DevVitek2/RODIA-Pathfinder/images/sch_bmp.png

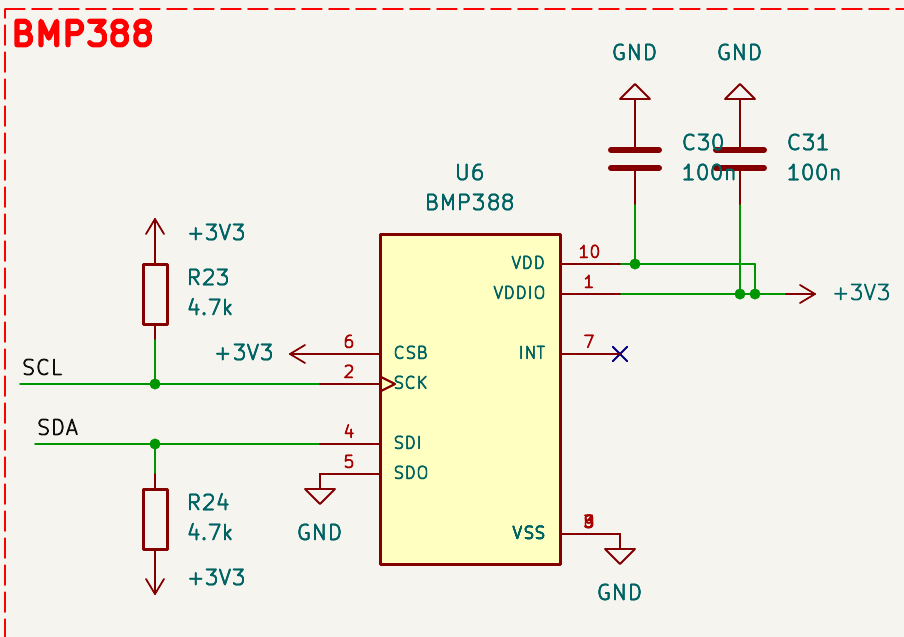
images/sch_bmp.png
