DevVitek2/RODIA-Pathfinder/images/sch_crystal.png

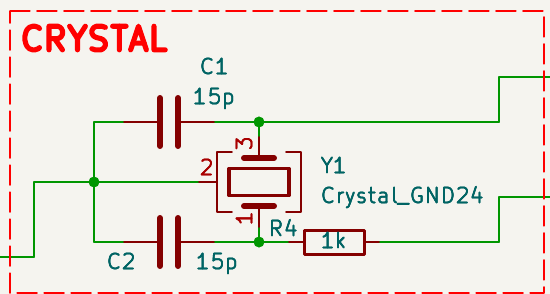
images/sch_crystal.png
