DevVitek2/RODIA-Pathfinder/images/sch_full.png

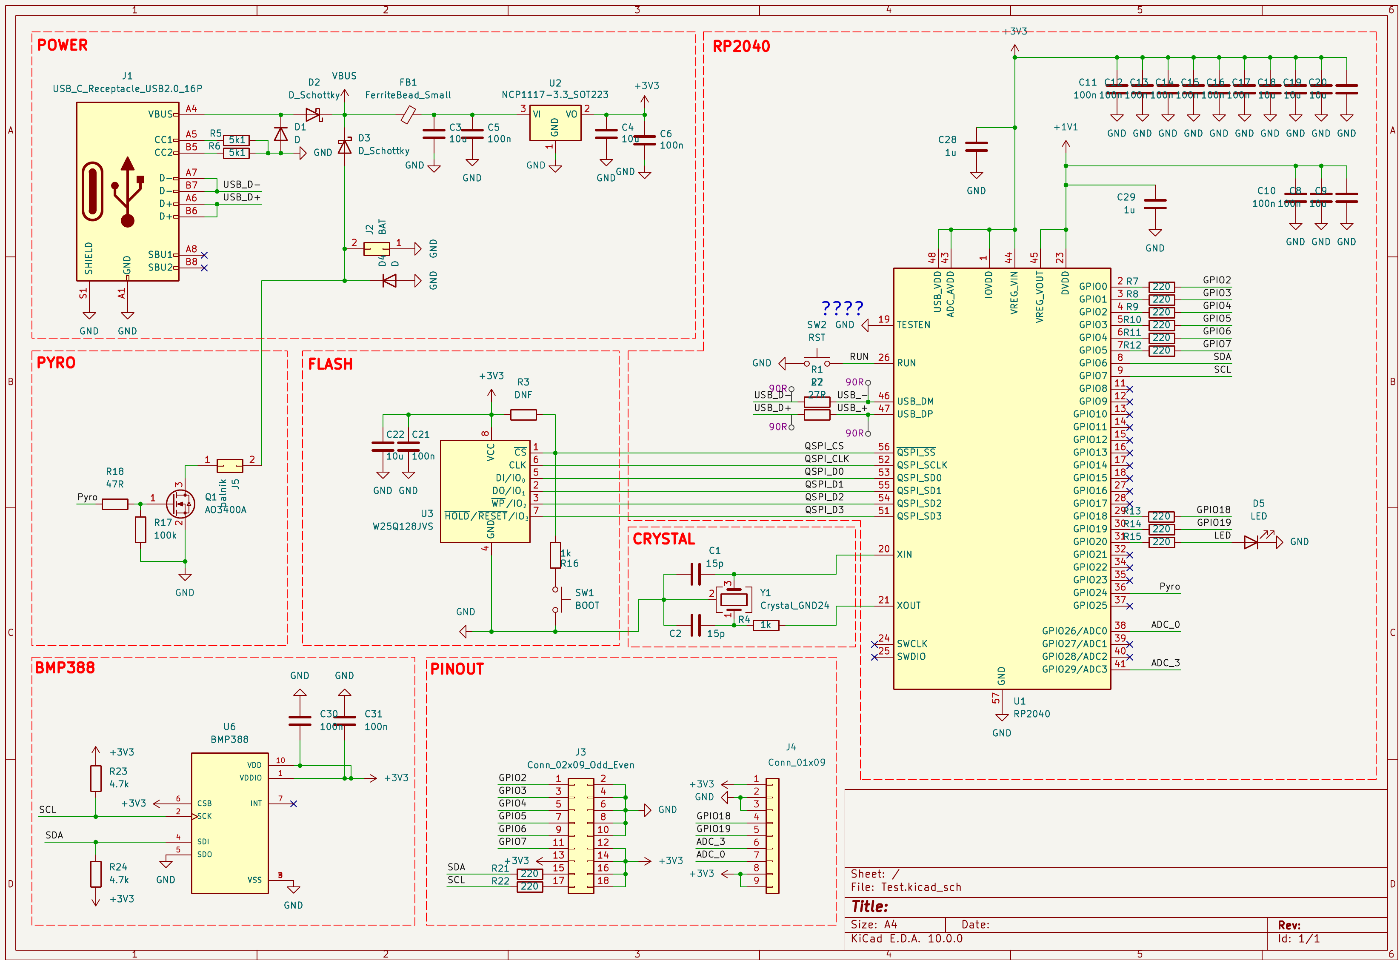
images/sch_full.png
