DevVitek2/RODIA-Pathfinder/images/sch_mcu.png

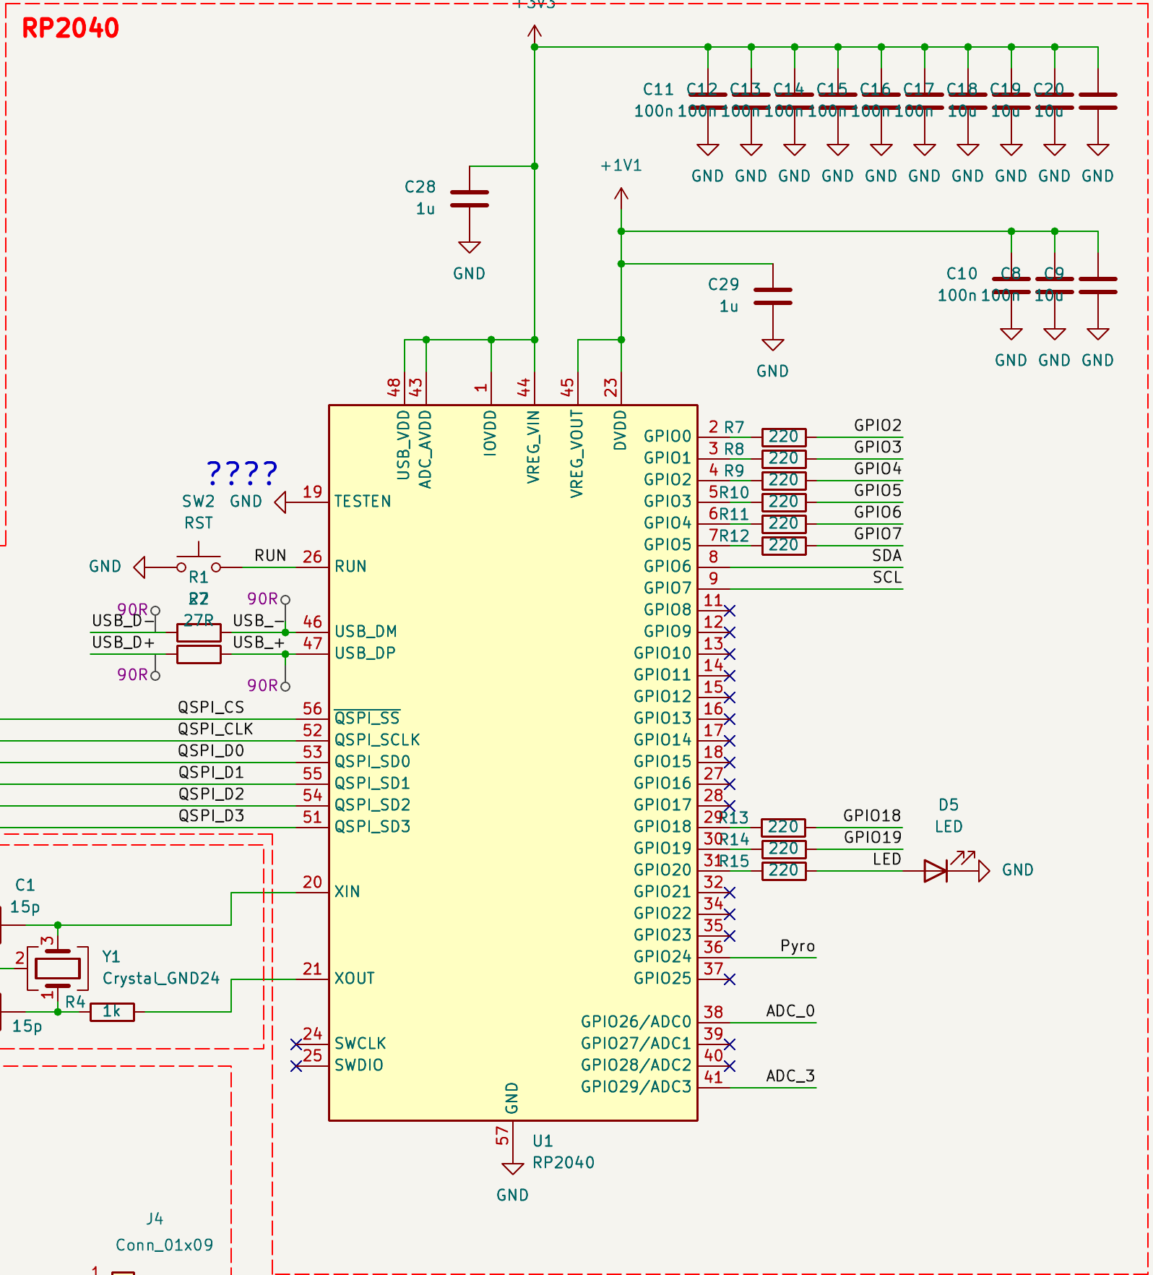
images/sch_mcu.png
