DevVitek2/RODIA-Pathfinder/images/sch_pinout.png

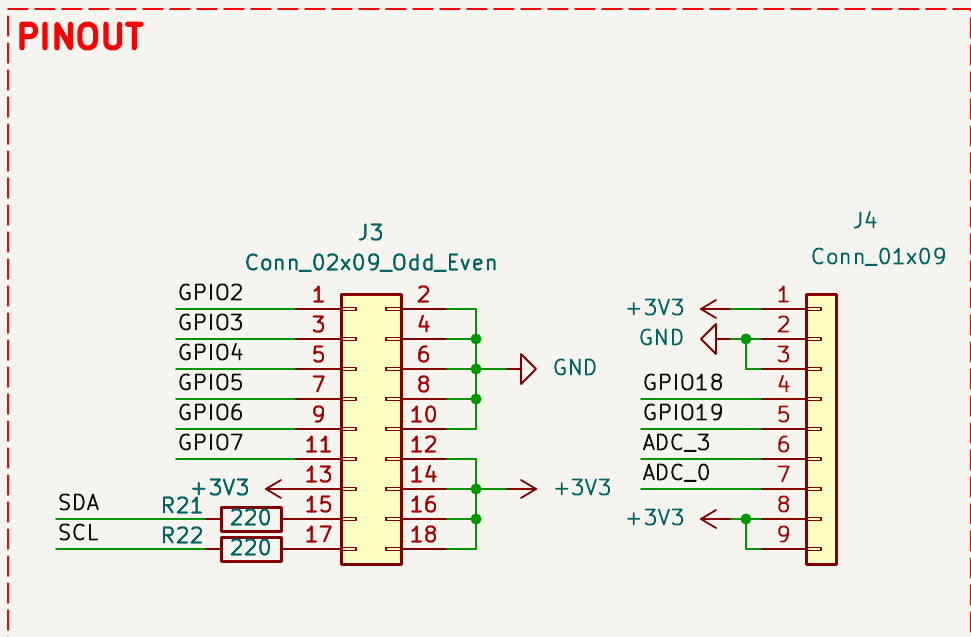
images/sch_pinout.png
