DevVitek2/RODIA-Pathfinder/images/sch_power.png

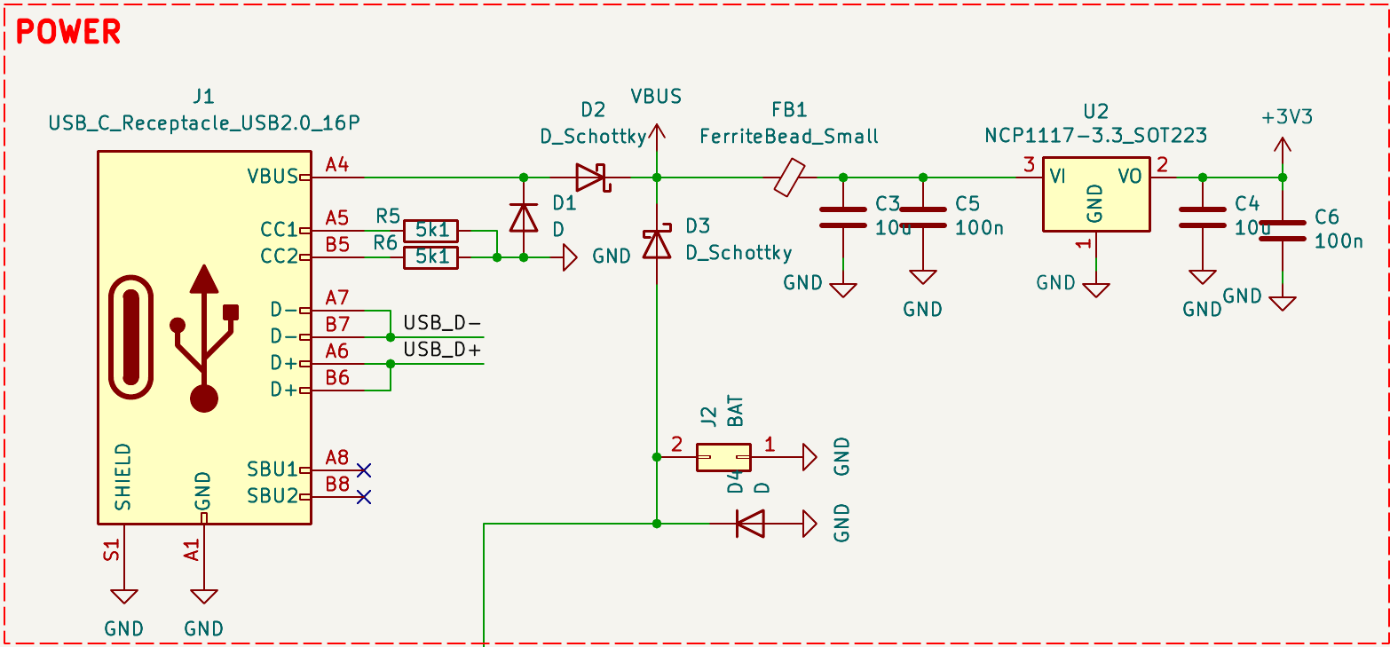
images/sch_power.png
