DevVitek2/RODIA-Pathfinder/rodia-pathfinder/PCB2.3_JF/imgs_production/2026-07-18_00-21.png

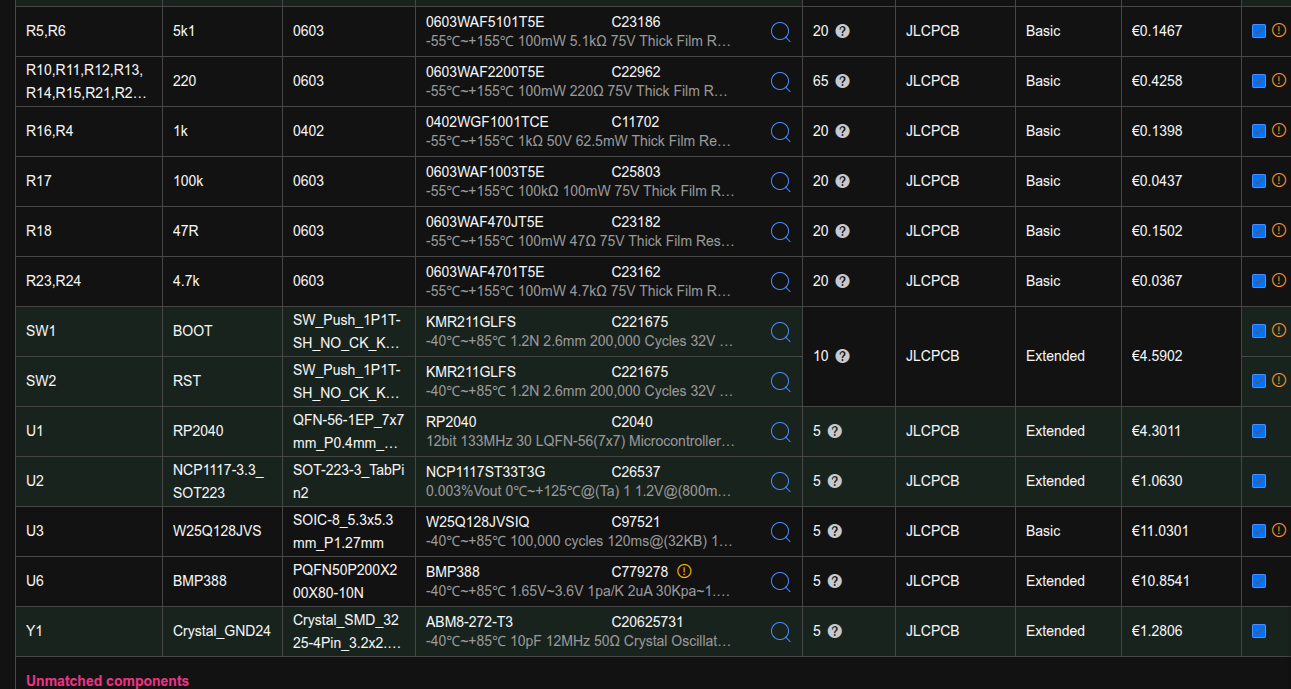
rodia-pathfinder/PCB2.3_JF/imgs_production/2026-07-18_00-21.png
