DevVitek2/RODIA-Pathfinder/rodia-pathfinder/PCB2.3_JF/production/bom.csv

Designator | Footprint | Quantity | Value | LCSC Part #
C1, C2 | 0402 | 2 | 15p
C10, C11, C12, C13, C14, C15, C16, C17, C21, C30, C31, C5, C6, C8 | 0402 | 14 | 100n
C18, C19, C20, C22, C3, C4, C9 | 0402 | 7 | 10u
C28, C29 | 0402 | 2 | 1u
D1, D4 | D_SMB | 2 | D
D2, D3 | D_SMA | 2 | D_Schottky
D5 | 0805 | 1 | LED
FB1 | 0805 | 1 | FerriteBead_Small
J1 | USB_C_Receptacle_HCTL_HC-TYPE-C-16P-01A | 1 | USB_C_Receptacle_USB2.0_16P
J2 | AMASS_XT30UPB-M_1x02_P5.0mm_Vertical | 1 | BAT
J3 | PinSocket_2x09_P2.54mm_Vertical | 1 | Conn_02x09_Odd_Even
J4 | PinSocket_1x09_P2.54mm_Vertical | 1 | Conn_01x09
J5 | AMASS_XT30UPB-M_1x02_P5.0mm_Vertical | 1 | palnik
Q1 | SOT-23 | 1 | AO3400A
R1 | 0402 | 1 | 27
R10, R11, R12, R13, R14, R15, R21, R22, R7, R8, R9 | 0603 | 11 | 220
R16, R4 | 0402 | 2 | 1k
R17 | 0603 | 1 | 100k
R18 | 0603 | 1 | 47R
R2 | 0402 | 1 | 27R
R23, R24 | 0603 | 2 | 4.7k
R3 | 0603 | 1 | DNF
R5, R6 | 0603 | 2 | 5k1
SW1 | SW_Push_1P1T-SH_NO_CK_KMR2xxG | 1 | BOOT
SW2 | SW_Push_1P1T-SH_NO_CK_KMR2xxG | 1 | RST
U1 | QFN-56-1EP_7x7mm_P0.4mm_EP3.2x3.2mm_ThermalVias | 1 | RP2040
U2 | SOT-223-3_TabPin2 | 1 | NCP1117-3.3_SOT223
U3 | SOIC-8_5.3x5.3mm_P1.27mm | 1 | W25Q128JVS
U6 | PQFN50P200X200X80-10N | 1 | BMP388
Y1 | Crystal_SMD_3225-4Pin_3.2x2.5mm | 1 | Crystal_GND24
