DevVitek2/RODIA-Pathfinder/images/schematic.pdf

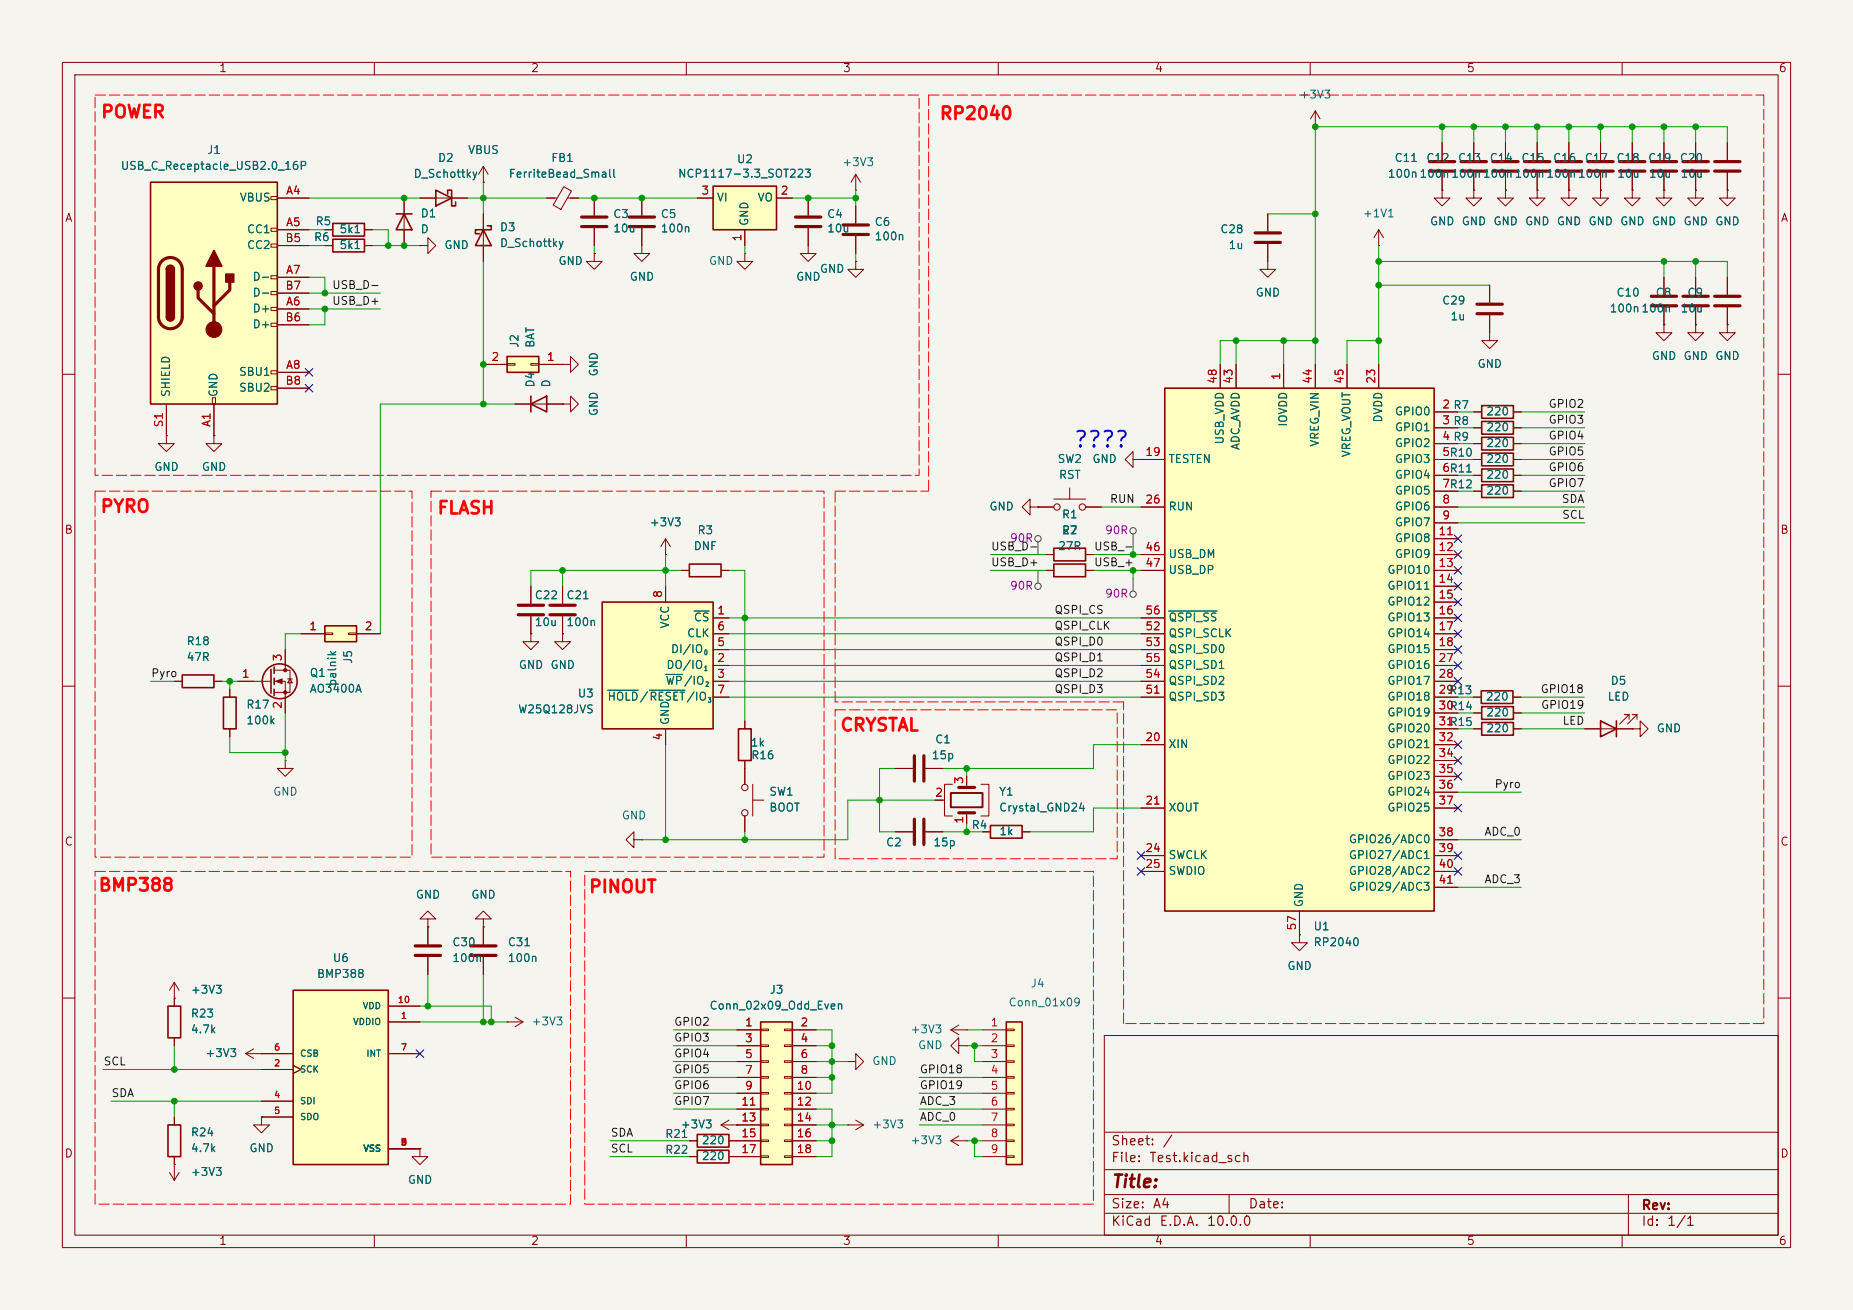
[picture p28: page 1]

2 3J5 palnik 1 2 U3 W25Q128JVS CS 1 DO/IO1 2 WP/IO2 3 GND

4 DI/IO0 5 CLK 6 HOLD/RESET/IO3 7 VCC

Size: A4 | Rev:
KiCad E.D.A. 10.0.0 | Id: 1/1
