DevVitek2/RODIA-Pathfinder/rodia/RODIA_block_diagram.pdf

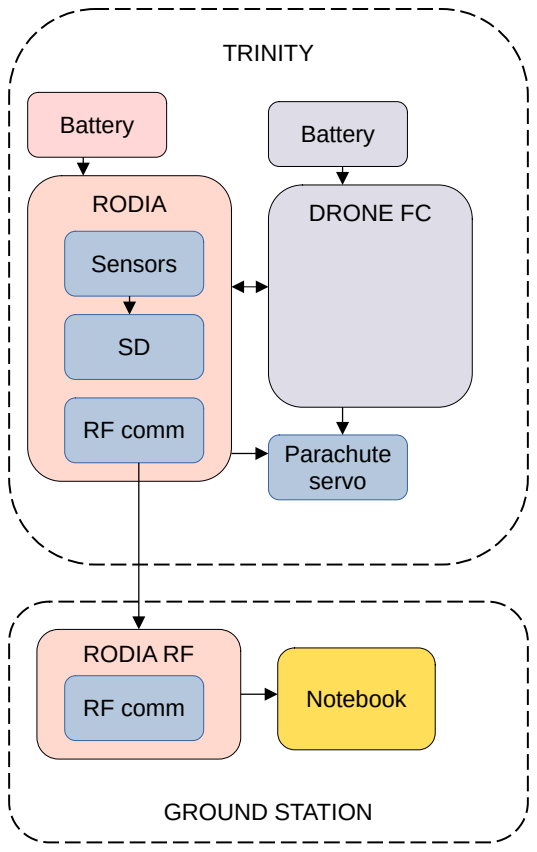
[picture p29: page 1]
RODIA; Sensors; RF comm; Battery; DRONE FC; RODIA RF; TRINITY; Parachute servo; GROUND STATION; Notebook
