DevVitek2/RODIA-Pathfinder/rodia-pathfinder/PCB2.3_JF/Test.kicad_pcb

## KiCad design rodia-pathfinder/PCB2.3_JF/Test.kicad_pcb (2026-10-26)

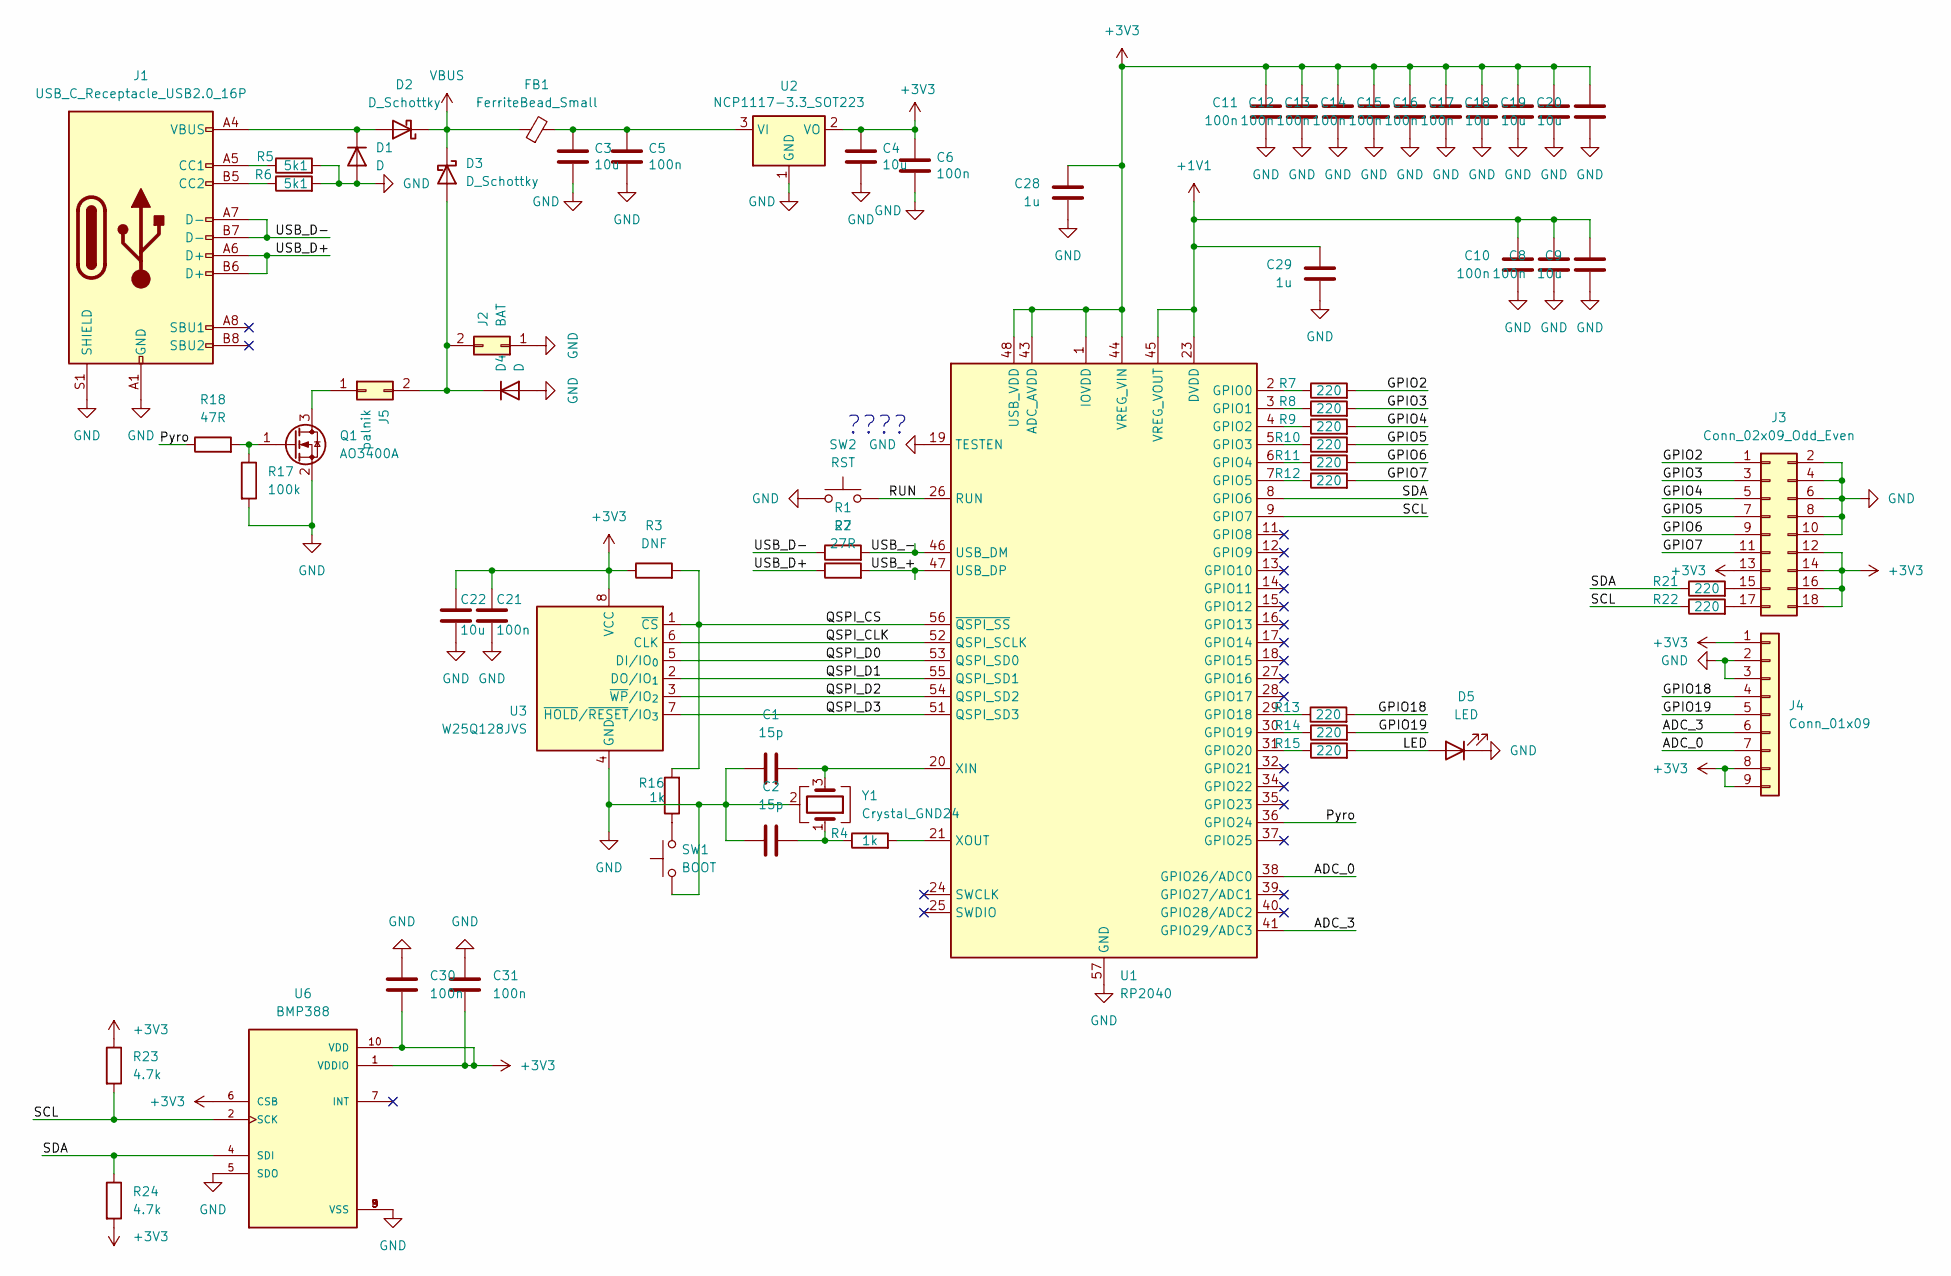
[picture p30: schematic Test.kicad_sch]

Parts:
C1, C2: 15p; C_0402_1005Metric
C3, C4, C9, C18, C19, C20, C22: 10u; C_0402_1005Metric
C5, C6, C8, C10, C11, C12, C13, C14, C15, C16, C17, C21, C30, C31: 100n; C_0402_1005Metric
C28, C29: 1u; C_0402_1005Metric
D1, D4: D; D_SMB
D2, D3: D_Schottky; D_SMA
D5: LED; LED_0805_2012Metric
FB1: FerriteBead_Small; R_0805_2012Metric
J1: USB_C_Receptacle_USB2.0_16P; USB_C_Receptacle_HCTL_HC-TYPE-C-16P-01A
J2: BAT; AMASS_XT30UPB-M_1x02_P5.0mm_Vertical
J3: Conn_02x09_Odd_Even; PinSocket_2x09_P2.54mm_Vertical
J4: Conn_01x09; PinSocket_1x09_P2.54mm_Vertical
J5: palnik; AMASS_XT30UPB-M_1x02_P5.0mm_Vertical
Q1: AO3400A; SOT-23
R1: 27; R_0402_1005Metric
R2: 27R; R_0402_1005Metric
R3: DNF; R_0603_1608Metric
R4, R16: 1k; R_0402_1005Metric
R5, R6: 5k1; R_0603_1608Metric
R7, R8, R9, R10, R11, R12, R13, R14, R15, R21, R22: 220; R_0603_1608Metric
R17: 100k; R_0603_1608Metric
R18: 47R; R_0603_1608Metric
R23, R24: 4.7k; R_0603_1608Metric
SW1: BOOT; SW_Push_1P1T-SH_NO_CK_KMR2xxG
SW2: RST; SW_Push_1P1T-SH_NO_CK_KMR2xxG
U1: RP2040; QFN-56-1EP_7x7mm_P0.4mm_EP3.2x3.2mm_ThermalVias
U2: NCP1117-3.3_SOT223; SOT-223-3_TabPin2
U3: W25Q128JVS; SOIC-8_5.3x5.3mm_P1.27mm
U6: BMP388; PQFN50P200X200X80-10N; PARTREV 1.1
Y1: Crystal_GND24; Crystal_SMD_3225-4Pin_3.2x2.5mm

Connections:
+1V1: C8.1, C9.1, C10.1, C29.1, U1.23 (DVDD), U1.45 (VREG_VOUT), U1.50 (DVDD)
+3V3: C4.1, C6.1, C11.1, C12.1, C13.1, C14.1, C15.1, C16.1, C17.1, C18.1, C19.1, C20.1, C21.1, C22.1, C28.1, C30.2, C31.2, J3.12, J3.13, J3.14, J3.16, J3.18, J4.1, J4.8, J4.9, R3.1, R23.1, R24.2, U1.1 (IOVDD), U1.10 (IOVDD), U1.22 (IOVDD), U1.33 (IOVDD), U1.42 (IOVDD), U1.43 (ADC_AVDD), U1.44 (VREG_VIN), U1.48 (USB_VDD), U1.49 (IOVDD), U2.2 (VO), U3.8 (VCC), U6.1 (VDDIO), U6.6 (CSB), U6.10 (VDD)
/ADC_0: J4.7, U1.38 (GPIO26/ADC0)
/ADC_3: J4.6, U1.41 (GPIO29/ADC3)
/GPIO2: J3.1, R7.2
/GPIO3: J3.3, R8.2
/GPIO4: J3.5, R9.2
/GPIO5: J3.7, R10.2
/GPIO6: J3.9, R11.2
/GPIO7: J3.11, R12.2
/GPIO18: J4.4, R13.2
/GPIO19: J4.5, R14.2
/LED: D5.2 (A), R15.2
/Pyro: R18.1, U1.36 (GPIO24)
/QSPI_CLK: U1.52 (QSPI_SCLK), U3.6 (CLK)
/QSPI_CS: R3.2, R16.2, U1.56 (~QSPI_SS), U3.1 (~CS)
/QSPI_D0: U1.53 (QSPI_SD0), U3.5 (DI/IO_{0})
/QSPI_D1: U1.55 (QSPI_SD1), U3.2 (DO/IO_{1})
/QSPI_D2: U1.54 (QSPI_SD2), U3.3 (~WP/IO_{2})
/QSPI_D3: U1.51 (QSPI_SD3), U3.7 (~HOLD/~RESET/IO_{3})
/RUN: SW2.1, U1.26 (RUN)
/SCL: R22.1, R23.2, U1.9 (GPIO7), U6.2 (SCK)
/SDA: R21.1, R24.1, U1.8 (GPIO6), U6.4 (SDI)
/USB_+: R2.2, U1.47 (USB_DP)
/USB_-: R1.2, U1.46 (USB_DM)
/USB_D+: J1.A6 (D+), J1.B6 (D+), R2.1
/USB_D-: J1.A7 (D-), J1.B7 (D-), R1.1
GND: C1.1, C2.1, C3.2, C4.2, C5.2, C6.2, C8.2, C9.2, C10.2, C11.2, C12.2, C13.2, C14.2, C15.2, C16.2, C17.2, C18.2, C19.2, C20.2, C21.2, C22.2, C28.2, C29.2, C30.1, C31.1, D1.2 (A), D4.2 (A), D5.1 (K), J1.A1 (GND), J1.A12 (GND), J1.B1 (GND), J1.B12 (GND), J1.S1 (SHIELD), J2.1, J3.2, J3.4, J3.6, J3.8, J3.10, J4.2, J4.3, Q1.2 (S), R5.2, R6.2, R17.2, SW1.1, SW2.2, U1.19 (TESTEN), U1.57 (GND), U2.1 (GND), U3.4 (GND), U6.3 (VSS), U6.5 (SDO), U6.8 (VSS), U6.9 (VSS), Y1.2 (G), Y1.4 (G)
unnamed: C2.2, R4.1, Y1.1
unnamed: D1.1 (K), D2.2 (A), J1.A4 (VBUS), J1.A9 (VBUS), J1.B4 (VBUS), J1.B9 (VBUS)
unnamed: D3.2 (A), D4.1 (K), J2.2, J5.2
unnamed: J1.A5 (CC1), R5.1
unnamed: J1.B5 (CC2), R6.1
unnamed: J3.15, R21.2
unnamed: J3.17, R22.2
unnamed: J5.1, Q1.3 (D)
unnamed: Q1.1 (G), R17.1, R18.2
unnamed: R16.1, SW1.2
unnamed: R7.1, U1.2 (GPIO0)
unnamed: R8.1, U1.3 (GPIO1)
unnamed: R9.1, U1.4 (GPIO2)
unnamed: R10.1, U1.5 (GPIO3)
unnamed: R11.1, U1.6 (GPIO4)
unnamed: R12.1, U1.7 (GPIO5)
unnamed: R13.1, U1.29 (GPIO18)
unnamed: R14.1, U1.30 (GPIO19)
unnamed: R15.1, U1.31 (GPIO20)
unnamed: C1.2, U1.20 (XIN), Y1.3
unnamed: R4.2, U1.21 (XOUT)
unnamed: C3.1, C5.1, FB1.2, U2.3 (VI)
VBUS: D2.1 (K), D3.1 (K), FB1.1

Notes on the sheet:
????

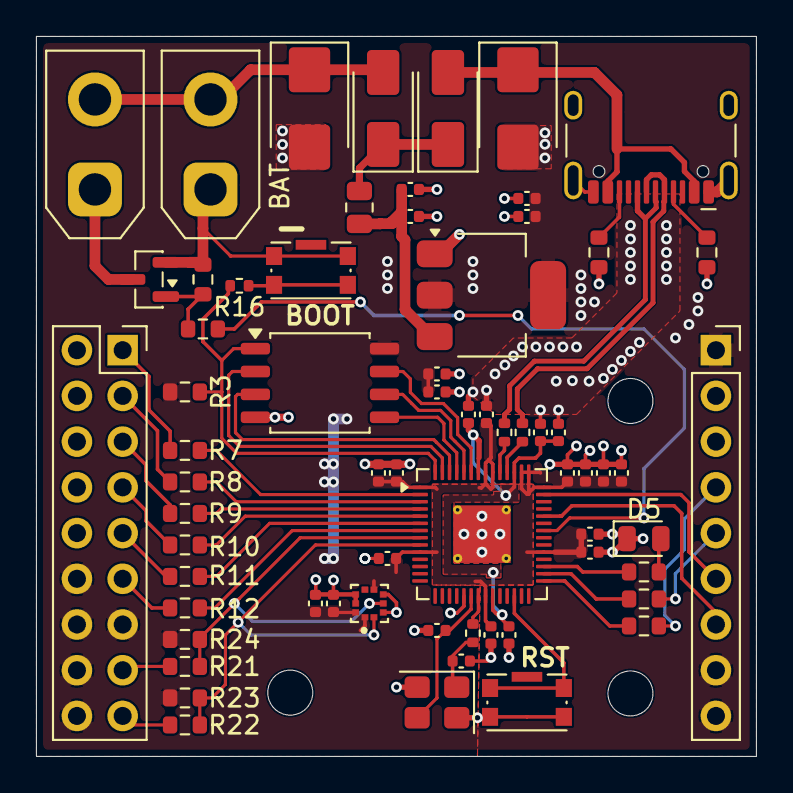
[picture p31: board Test.kicad_pcb from above]

Board: 2 copper layers, 40.0 x 40.0 mm, 66 parts (0 on the bottom side), 51 nets.
