DevVitek2/RODIA-Pathfinder/rodia-pathfinder/Sensor_board_1.2/Sensor_board_1.2.kicad_pcb

## KiCad design rodia-pathfinder/Sensor_board_1.2/Sensor_board_1.2.kicad_pcb (2026-10-26)

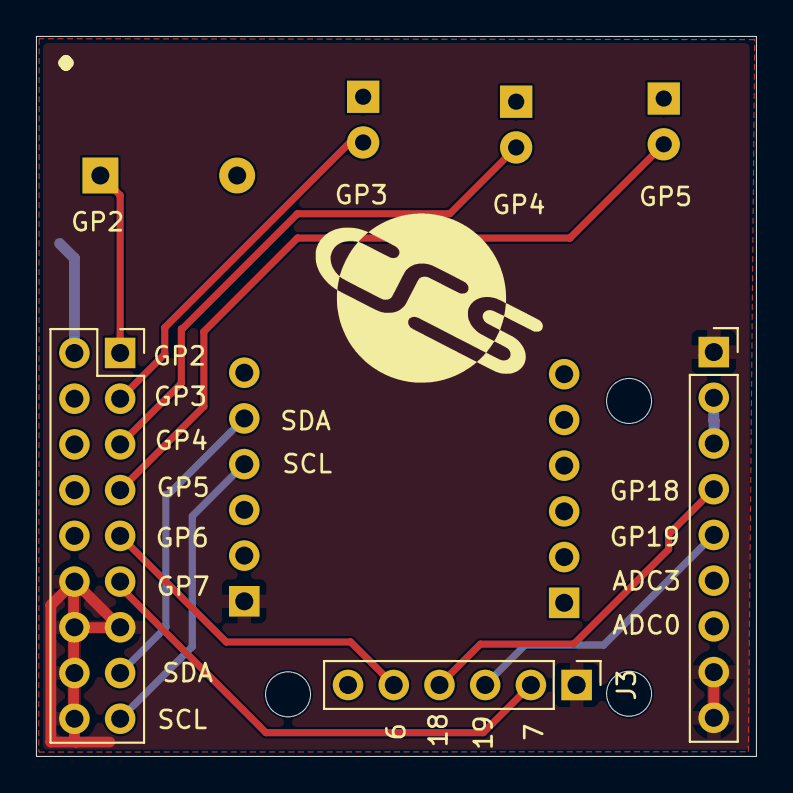
[picture p32: board Sensor_board_1.2.kicad_pcb from above]

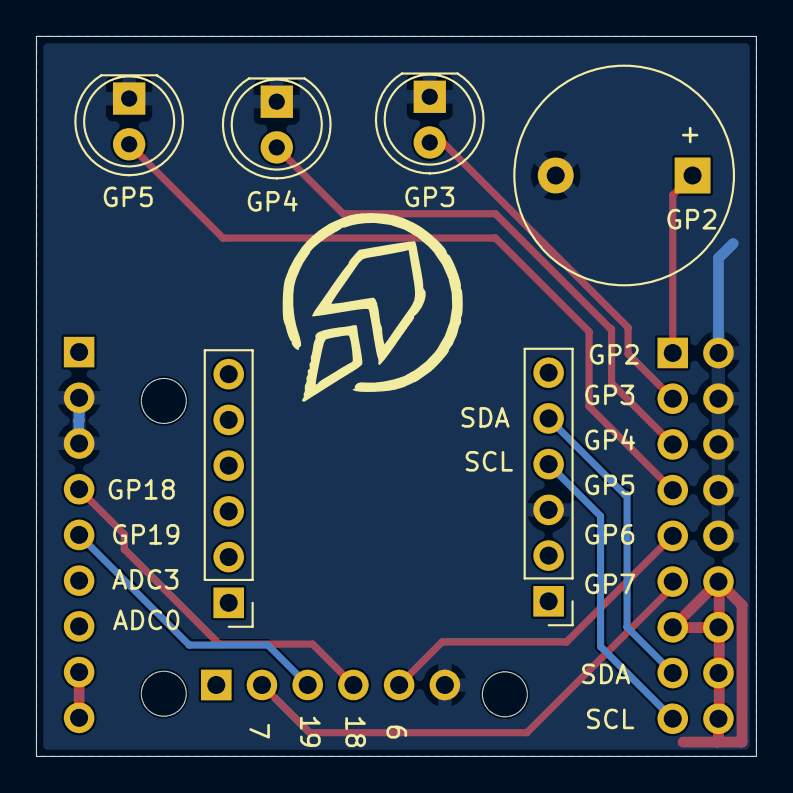
[picture p33: board Sensor_board_1.2.kicad_pcb from below]

Board: 2 copper layers, 40.0 x 40.0 mm, 9 parts (5 on the bottom side), 12 nets.

Parts:
BZ1: Buzzer; Buzzer_12x9.5RM7.6
D1, D2, D3: LED; LED_D5.0mm
J1, J2, J3: Conn_01x06; PinSocket_1x06_P2.54mm_Vertical
J5: Conn_02x09_Odd_Even; PinSocket_2x09_P2.54mm_Vertical
J6: Conn_01x09; PinSocket_1x09_P2.54mm_Vertical

Connections:
+3V3: J2.1, J3.1, J5.12, J5.13, J5.14, J5.16, J5.18, J6.1, J6.8, J6.9
/GPIO2: BZ1.1 (+), J5.1
/GPIO3: D2.2 (A), J5.3
/GPIO4: D1.2 (A), J5.5
/GPIO5: D3.2 (A), J5.7
/GPIO6: J3.5, J5.9
/GPIO7: J3.2, J5.11
/GPIO18: J3.4, J6.4
/GPIO19: J3.3, J6.5
/SCL: J2.4, J5.17
/SDA: J2.5, J5.15
GND: BZ1.2 (-), D1.1 (K), D2.1 (K), D3.1 (K), J2.3, J3.6, J5.2, J5.4, J5.6, J5.8, J5.10, J6.2, J6.3
